jackzfdai/wifi_camera/README.md

# wifi_camera
ESP32 based connected camera, includes PCB files, ESP32 code, and a Python server for receiving the video stream.
