jackzfdai/wifi_camera/firmware/README.md

# ESP32 Camera Code 

Under development.
