jackzfdai/wifi_camera/hardware/CAMERA_MODULE.brd

## EAGLE design hardware/CAMERA_MODULE.brd (2020-05-04)

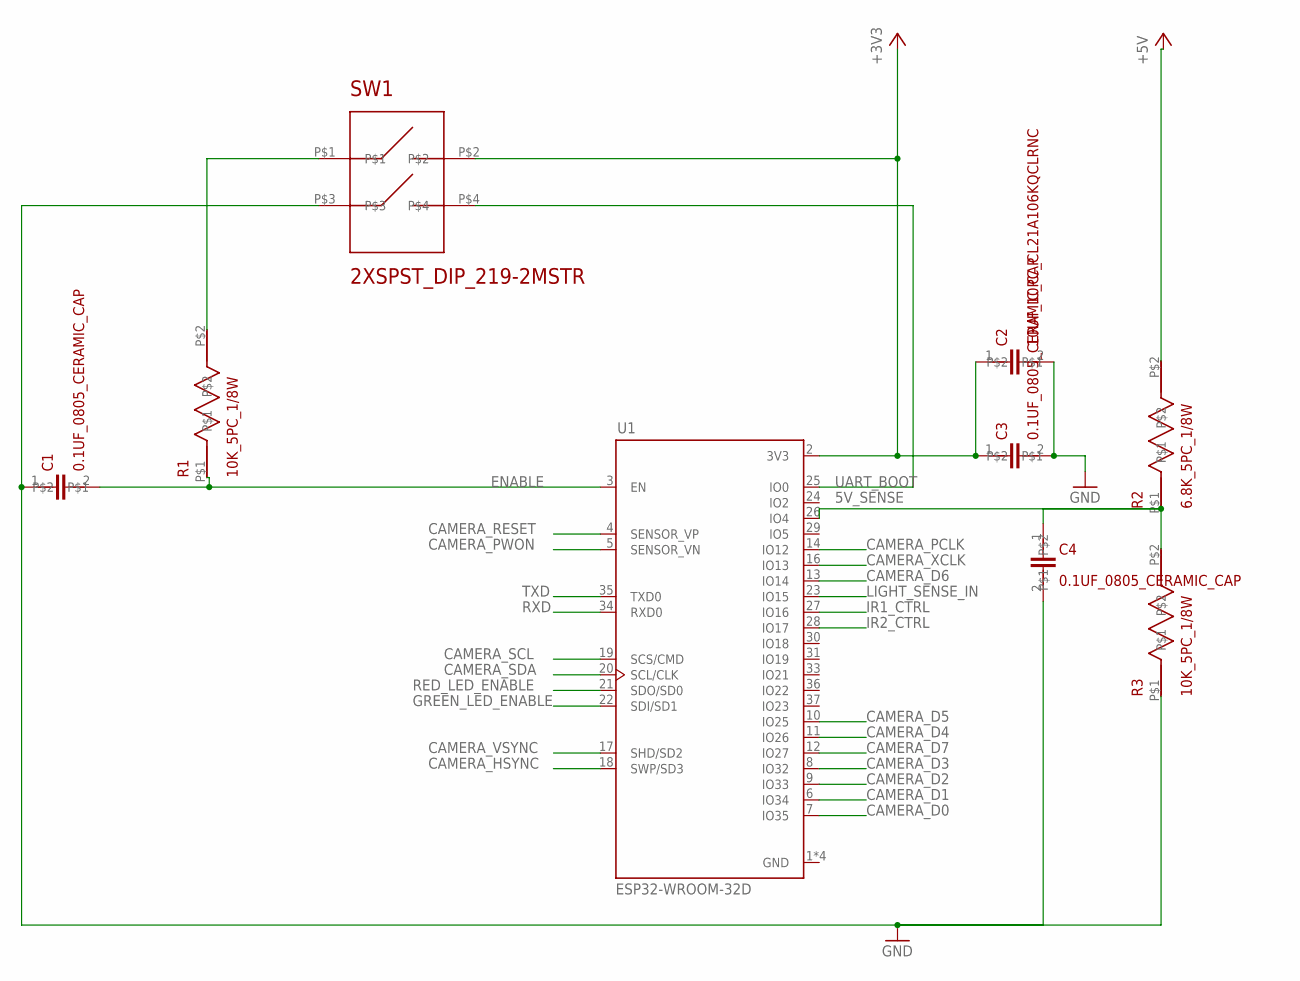
[picture p1: schematic CAMERA_MODULE.sch, sheet 1]

Parts:
C1, C3, C4: 0.1UF_0805_CERAMIC_CAP; C0805K
C2: 10UF_10PC_CL21A106KQCLRNC; C0805K
R1, R3: 10K_5PC_1/8W; 0805_1
R2: 6.8K_5PC_1/8W; 0805_1
SW1: 2XSPST_DIP_219-2MSTR; 2XSPST
U1: ESP32-WROOM-32D; MODULE_ESP32-WROOM-32D

Connections:
5V_SENSE: C4.1, R2.P$1, R3.P$2, U1.26 (IO4)
+3V3: C2.1, C3.1, SW1.P$2, U1.2 (3V3); also elsewhere on the board
+5V: R2.P$2; also elsewhere on the board
CAMERA_D0: U1.7 (IO35); also elsewhere on the board
CAMERA_D1: U1.6 (IO34); also elsewhere on the board
CAMERA_D2: U1.9 (IO33); also elsewhere on the board
CAMERA_D3: U1.8 (IO32); also elsewhere on the board
CAMERA_D4: U1.11 (IO26); also elsewhere on the board
CAMERA_D5: U1.10 (IO25); also elsewhere on the board
CAMERA_D6: U1.13 (IO14); also elsewhere on the board
CAMERA_D7: U1.12 (IO27); also elsewhere on the board
CAMERA_HSYNC: U1.18 (SWP/SD3); also elsewhere on the board
CAMERA_PCLK: U1.14 (IO12); also elsewhere on the board
CAMERA_PWON: U1.5 (SENSOR_VN); also elsewhere on the board
CAMERA_RESET: U1.4 (SENSOR_VP); also elsewhere on the board
CAMERA_SCL: U1.19 (SCS/CMD); also elsewhere on the board
CAMERA_SDA: U1.20 (SCL/CLK); also elsewhere on the board
CAMERA_VSYNC: U1.17 (SHD/SD2); also elsewhere on the board
CAMERA_XCLK: U1.16 (IO13); also elsewhere on the board
ENABLE: C1.2, R1.P$1, U1.3 (EN)
GND: C1.1, C2.2, C3.2, C4.2, R3.P$1, SW1.P$3, U1.1 (GND), U1.15 (GND), U1.38 (GND), U1.39 (GND); also elsewhere on the board
GREEN_LED_ENABLE: U1.22 (SDI/SD1); also elsewhere on the board
IR1_CTRL: U1.27 (IO16); also elsewhere on the board
IR2_CTRL: U1.28 (IO17); also elsewhere on the board
LIGHT_SENSE_IN: U1.23 (IO15); also elsewhere on the board
unnamed: R1.P$2, SW1.P$1
RED_LED_ENABLE: U1.21 (SDO/SD0); also elsewhere on the board
RXD: U1.34 (RXD0); also elsewhere on the board
TXD: U1.35 (TXD0); also elsewhere on the board
UART_BOOT: SW1.P$4, U1.25 (IO0)

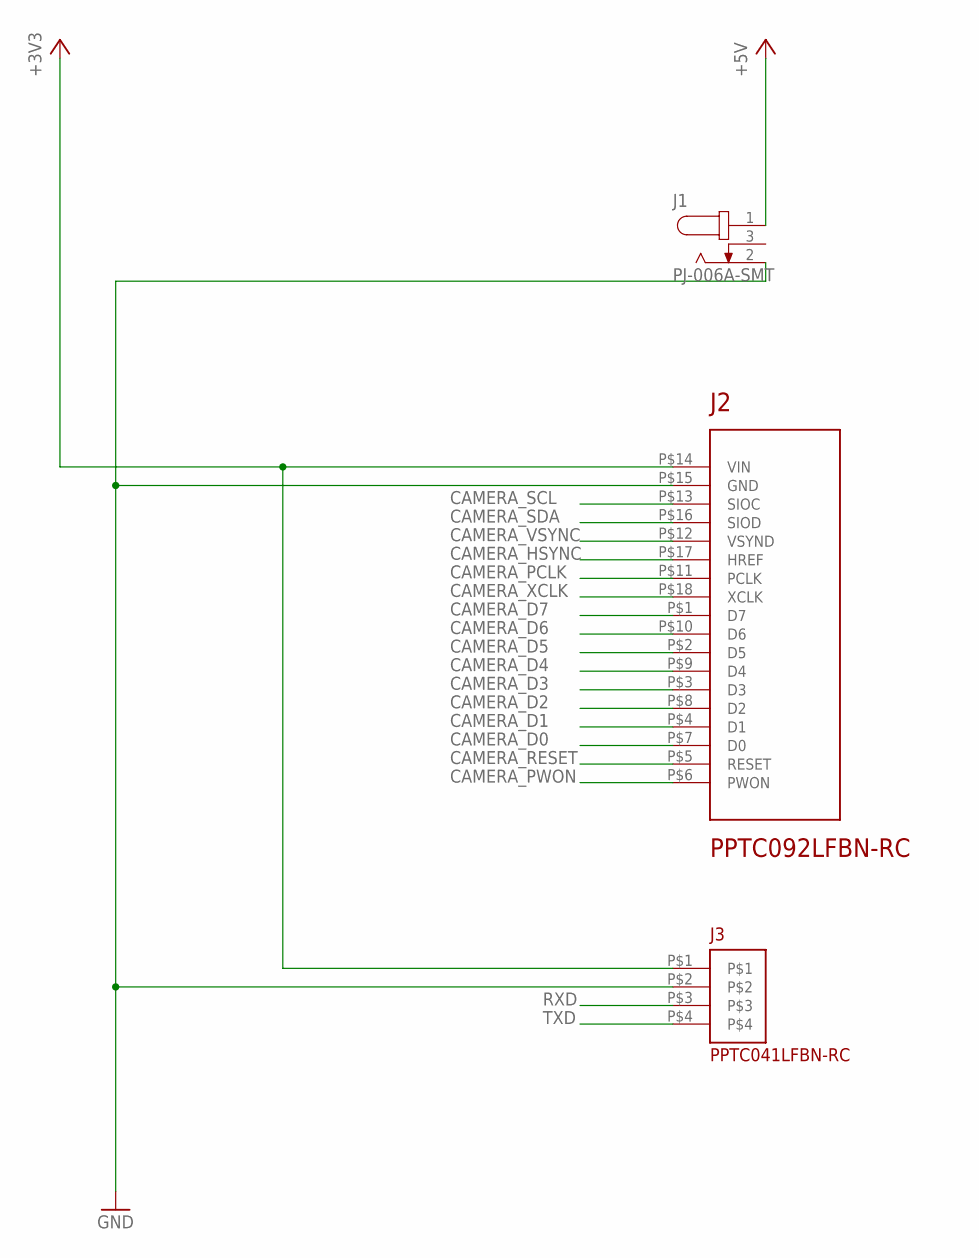
[picture p2: schematic CAMERA_MODULE.sch, sheet 2]

Parts:
J1: PJ-006A-SMT; CUI_PJ-006A-SMT
J2: PPTC092LFBN-RC; 2X9_0.1INCH
J3: PPTC041LFBN-RC; 1X4_0.1INCH

Connections:
+3V3: J2.P$14 (VIN), J3.P$1; also elsewhere on the board
+5V: J1.1; also elsewhere on the board
CAMERA_D0: J2.P$7 (D0); also elsewhere on the board
CAMERA_D1: J2.P$4 (D1); also elsewhere on the board
CAMERA_D2: J2.P$8 (D2); also elsewhere on the board
CAMERA_D3: J2.P$3 (D3); also elsewhere on the board
CAMERA_D4: J2.P$9 (D4); also elsewhere on the board
CAMERA_D5: J2.P$2 (D5); also elsewhere on the board
CAMERA_D6: J2.P$10 (D6); also elsewhere on the board
CAMERA_D7: J2.P$1 (D7); also elsewhere on the board
CAMERA_HSYNC: J2.P$17 (HREF); also elsewhere on the board
CAMERA_PCLK: J2.P$11 (PCLK); also elsewhere on the board
CAMERA_PWON: J2.P$6 (PWON); also elsewhere on the board
CAMERA_RESET: J2.P$5 (RESET); also elsewhere on the board
CAMERA_SCL: J2.P$13 (SIOC); also elsewhere on the board
CAMERA_SDA: J2.P$16 (SIOD); also elsewhere on the board
CAMERA_VSYNC: J2.P$12 (VSYND); also elsewhere on the board
CAMERA_XCLK: J2.P$18 (XCLK); also elsewhere on the board
GND: J1.2, J2.P$15 (GND), J3.P$2; also elsewhere on the board
RXD: J3.P$3; also elsewhere on the board
TXD: J3.P$4; also elsewhere on the board

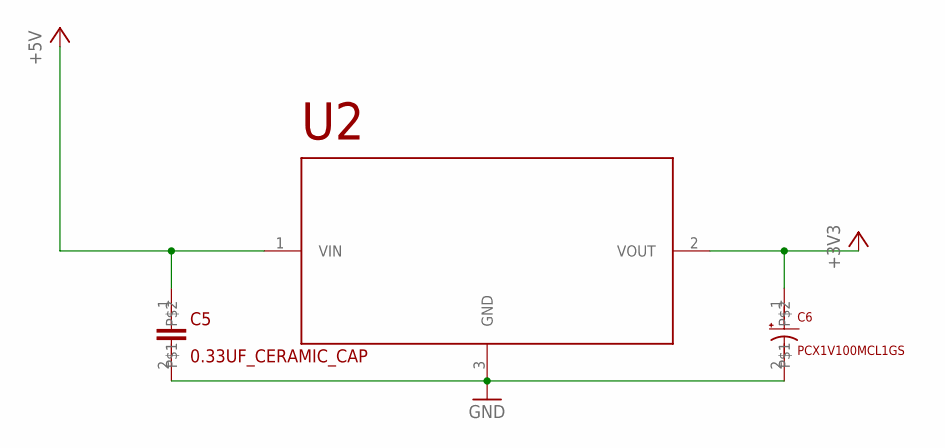
[picture p3: schematic CAMERA_MODULE.sch, sheet 3]

Parts:
C5: 0.33UF_CERAMIC_CAP; CAPC3216X110N
C6: PCX1V100MCL1GS; CAPAE660X600N
U2: LD29150DT33R; VREG_L7805CDT-TR

Connections:
+3V3: C6.1, U2.2 (VOUT); also elsewhere on the board
+5V: C5.1, U2.1 (VIN); also elsewhere on the board
GND: C5.2, C6.2, U2.3 (GND); also elsewhere on the board

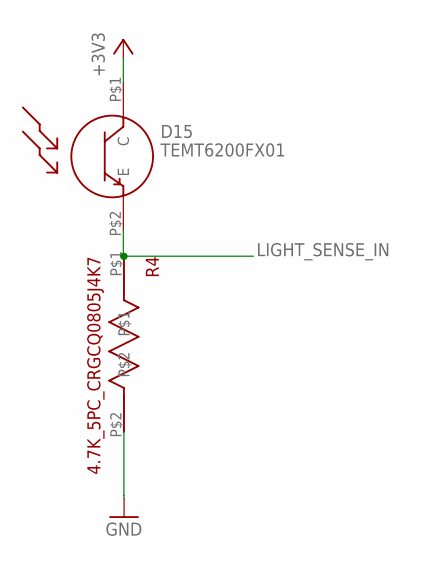
[picture p4: schematic CAMERA_MODULE.sch, sheet 4]

Parts:
D15: TEMT6200FX01; TEMT6200FX01_0805
R4: 4.7K_5PC_CRGCQ0805J4K7; 0805_1

Connections:
+3V3: D15.P$1 (C); also elsewhere on the board
GND: R4.P$2; also elsewhere on the board
LIGHT_SENSE_IN: D15.P$2 (E), R4.P$1; also elsewhere on the board

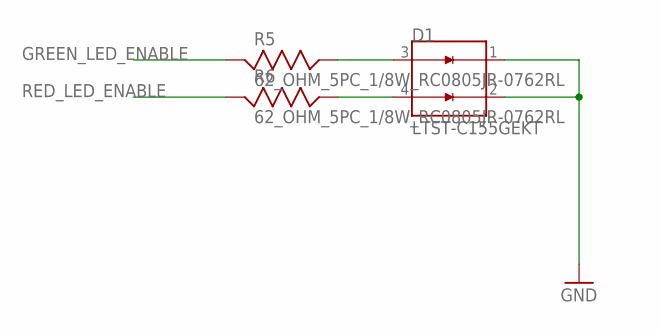
[picture p5: schematic CAMERA_MODULE.sch, sheet 5]

Parts:
D1: LTST-C155GEKT; LED_LTST-C155GEKT
R5, R6: 62_OHM_5PC_1/8W_RC0805JR-0762RL; 0805_1

Connections:
GND: D1.1, D1.2; also elsewhere on the board
GREEN_LED_ENABLE: R5.P$1 (1); also elsewhere on the board
unnamed: D1.3, R5.P$2 (2)
unnamed: D1.4, R6.P$2 (2)
RED_LED_ENABLE: R6.P$1 (1); also elsewhere on the board

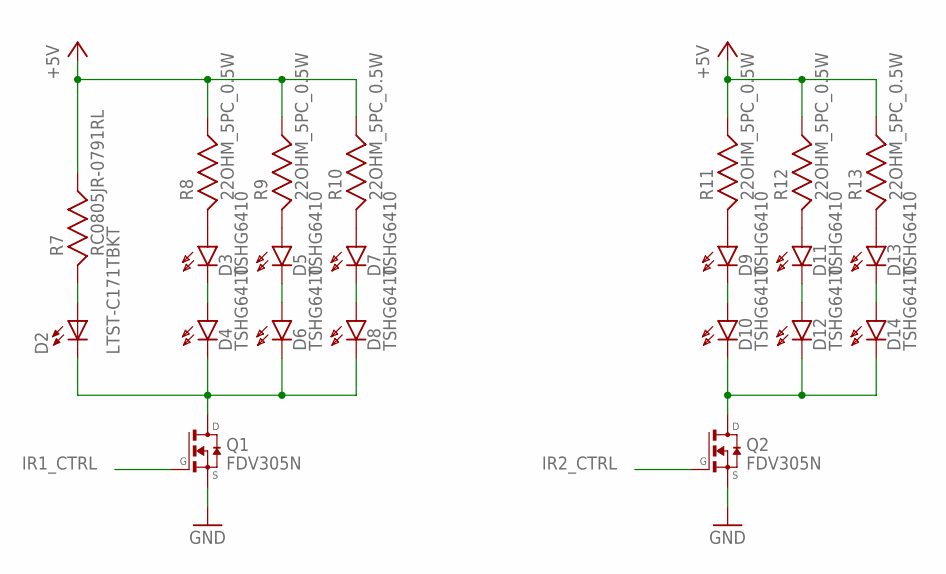
[picture p6: schematic CAMERA_MODULE.sch, sheet 6]

Parts:
D2: LTST-C171TBKT; DIOC200X125X110
D3, D4, D5, D6, D7, D8, D9, D10, D11, D12, D13, D14: TSHG6410; T1_LED_REAR_MOUNT
Q1, Q2: FDV305N; SOT23
R7: RC0805JR-0791RL; RESC2012X60
R8, R9, R10, R11, R12, R13: 22OHM_5PC_0.5W; 1206_RESISTOR

Connections:
+5V: R7.2, R8.P$2 (2), R9.P$2 (2), R10.P$2 (2), R11.P$2 (2), R12.P$2 (2), R13.P$2 (2); also elsewhere on the board
GND: Q1.2 (S), Q2.2 (S); also elsewhere on the board
IR1_CTRL: Q1.1 (G); also elsewhere on the board
IR2_CTRL: Q2.1 (G); also elsewhere on the board
unnamed: D2.+, R7.1
unnamed: D2.-, D4.P$2 (K), D6.P$2 (K), D8.P$2 (K), Q1.3 (D)
unnamed: D5.P$1 (A), R9.P$1 (1)
unnamed: D7.P$1 (A), R10.P$1 (1)
unnamed: D9.P$1 (A), R11.P$1 (1)
unnamed: D11.P$1 (A), R12.P$1 (1)
unnamed: D13.P$1 (A), R13.P$1 (1)
unnamed: D3.P$1 (A), R8.P$1 (1)
unnamed: D10.P$2 (K), D12.P$2 (K), D14.P$2 (K), Q2.3 (D)
unnamed: D3.P$2 (K), D4.P$1 (A)
unnamed: D5.P$2 (K), D6.P$1 (A)
unnamed: D7.P$2 (K), D8.P$1 (A)
unnamed: D9.P$2 (K), D10.P$1 (A)
unnamed: D11.P$2 (K), D12.P$1 (A)
unnamed: D13.P$2 (K), D14.P$1 (A)

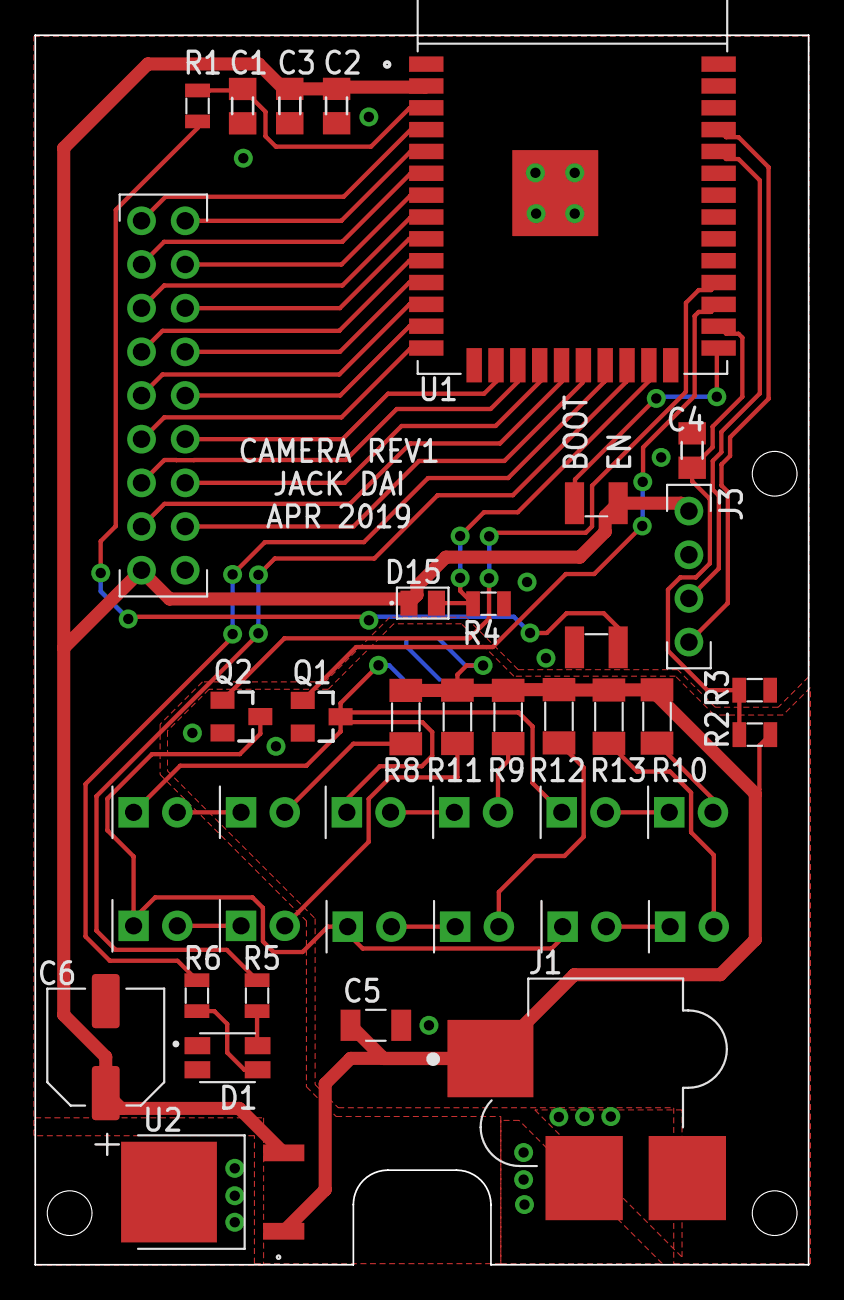
[picture p7: board CAMERA_MODULE.brd from above]

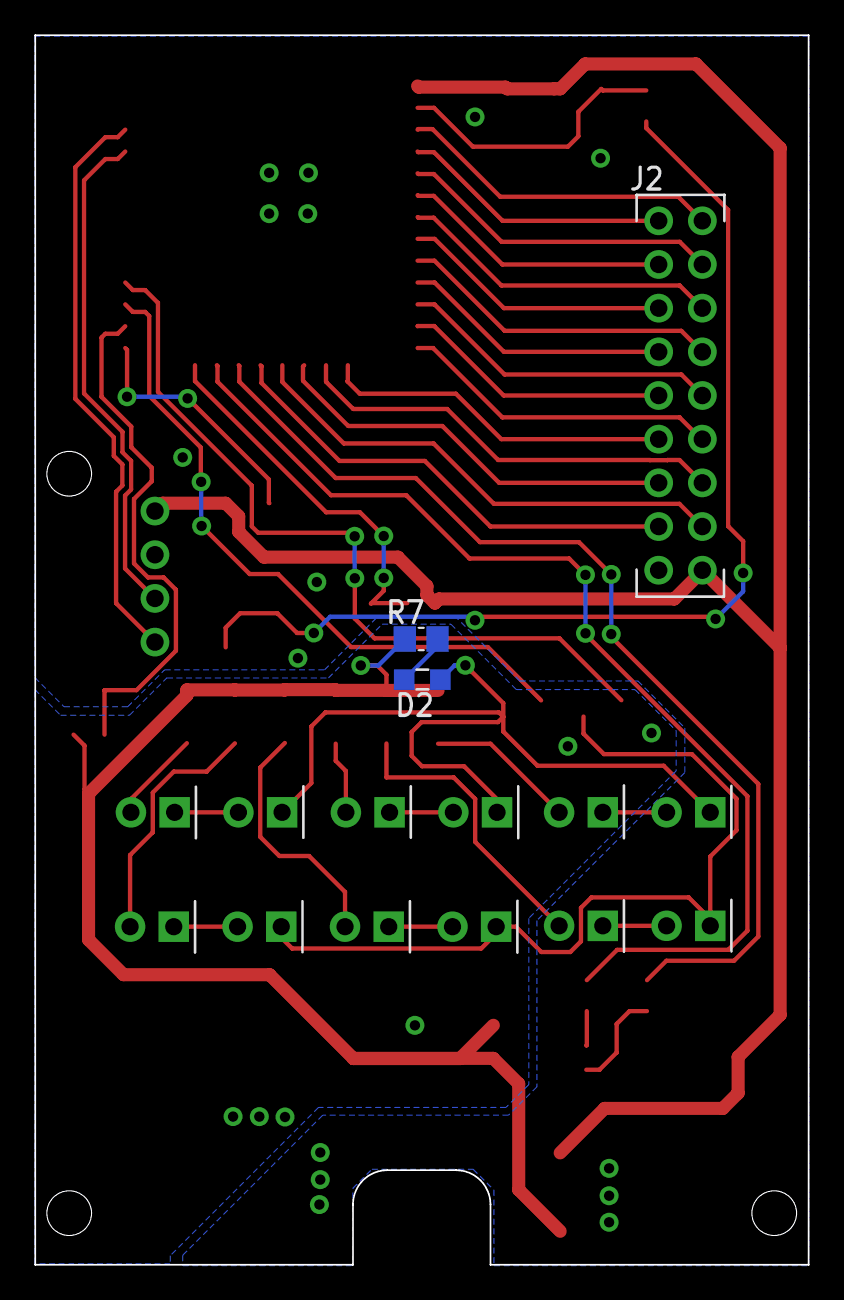
[picture p8: board CAMERA_MODULE.brd from below]

Board: 2 copper layers, 45.0 x 71.5 mm, 42 parts (2 on the bottom side), 47 nets.
