jackzfdai/wifi_camera/firmware/components/camera_module/include/camera_module.h

#ifndef CAMERA_MODULE_H
#define CAMERA_MODULE_H

#include <stdio.h>
#include <stdlib.h>
#include <stdint.h>

#include "freertos/FreeRTOS.h"
#include "freertos/queue.h"
#include "freertos/task.h"
#include "esp_err.h"

#define CAMERA_MODULE_BASE		40

#define CAMERA_TASK_PRIO		7

extern TaskHandle_t camera_task;

esp_err_t camera_module_init();

esp_err_t camera_get_jpeg(void** buf_adr, uint32_t* size, TickType_t xTicksToWait);

esp_err_t camera_return_jpeg(void *buf_adr);

#endif
