jackzfdai/wifi_camera/(commit log)

2020-05-04 cleaned up git, ready to push to github. Working video compression and transfer. Working server prototype.
    [CAMERA_MODULE.brd, CAMERA_MODULE.csv, CAMERA_MODULE.sch]
2020-05-04 fixed bug in server code, improved frame rate w/ multiple frame buffers.
    [camera.c, camera_module.c, main.c]
2020-05-06 debugged scrolling camera.
2020-05-08 init network fsm w/o errors.
    [state_machine.c, state_machine.h, system_mgmt.c, system_mgmt.h]
2020-05-24 changed network protocol. Modifed python video client. python video client can now handle multiple web streams and send control frames to cameras.
